Quinteto-de-nos/lumbapp/README.md

# lumbapp
Repo principal del simulador de puncion lumbar
