Quinteto-de-nos/lumbapp/LumbApp/README.txt

Podés enviar tus consultas a: info.lumbapp@gmail.com

Nuestro repo de Github es: https://github.com/Quinteto-de-nos/lumbapp
