Quinteto-de-nos/lumbapp/LumbApp/docs/Manual de instalación.pdf

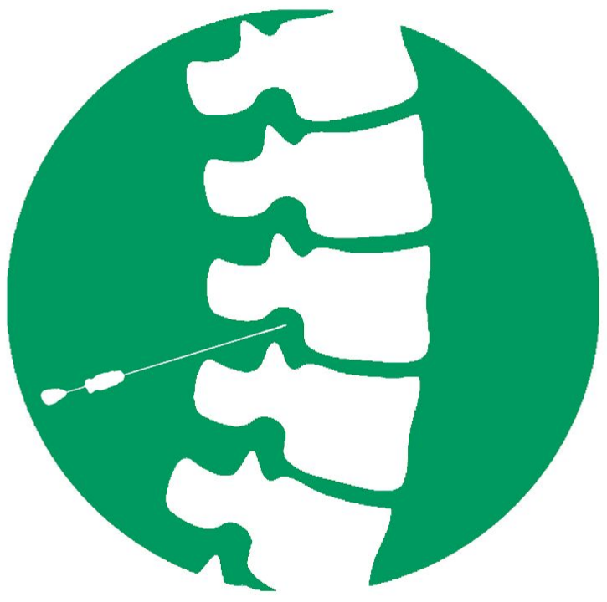
[picture p15: figure]

# Manual de Instalación

Gracias por elegir LumbApp, el simulador de punciones lumbares.
LumbApp es más que un simple simulador: es un guía virtual que acompañará al practicante durante cada práctica.
Para poder utilizar LumbApp, deberá instalar la aplicación de escritorio.

## Archivos de instalación

La aplicación LumbApp incluye un archivo de instalación llamado “LumbApp Desktop.msi”, que incluye todo lo necesario para instalar la aplicación de escritorio LumbApp.

## Pasos de instalación

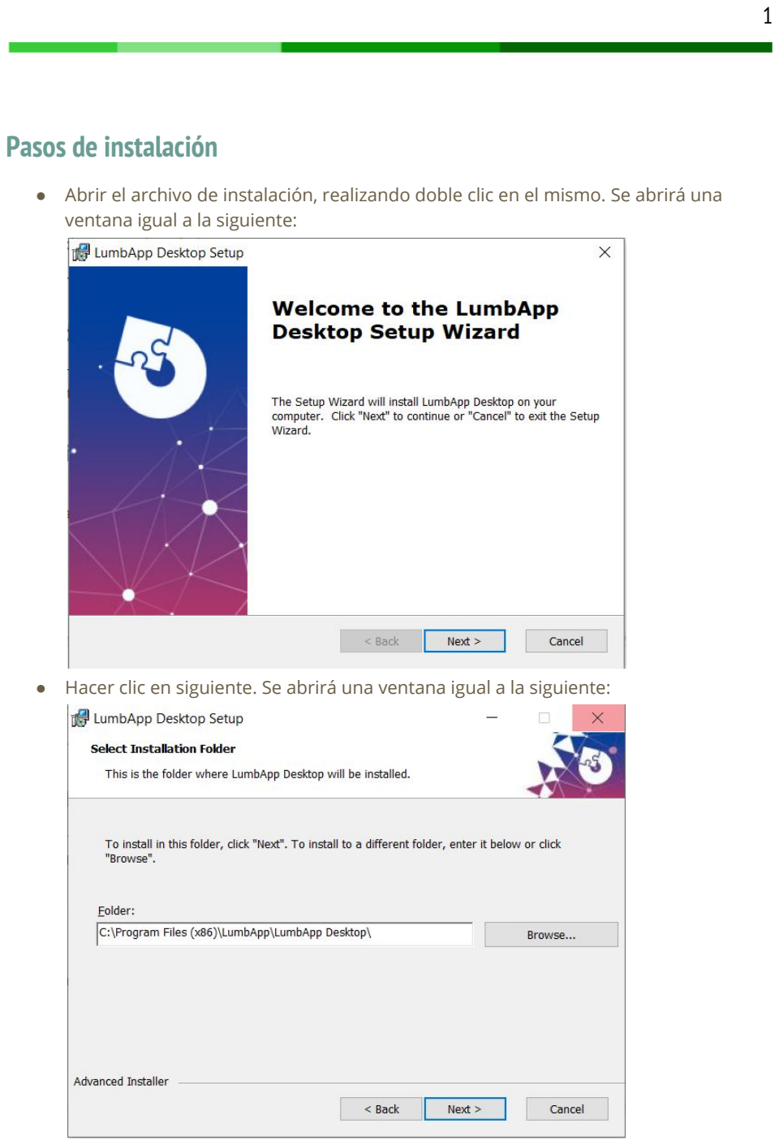
[picture p16: page 2]

- Abrir el archivo de instalación, realizando doble clic en el mismo. Se abrirá una ventana igual a la siguiente:
- Hacer clic en siguiente. Se abrirá una ventana igual a la siguiente:

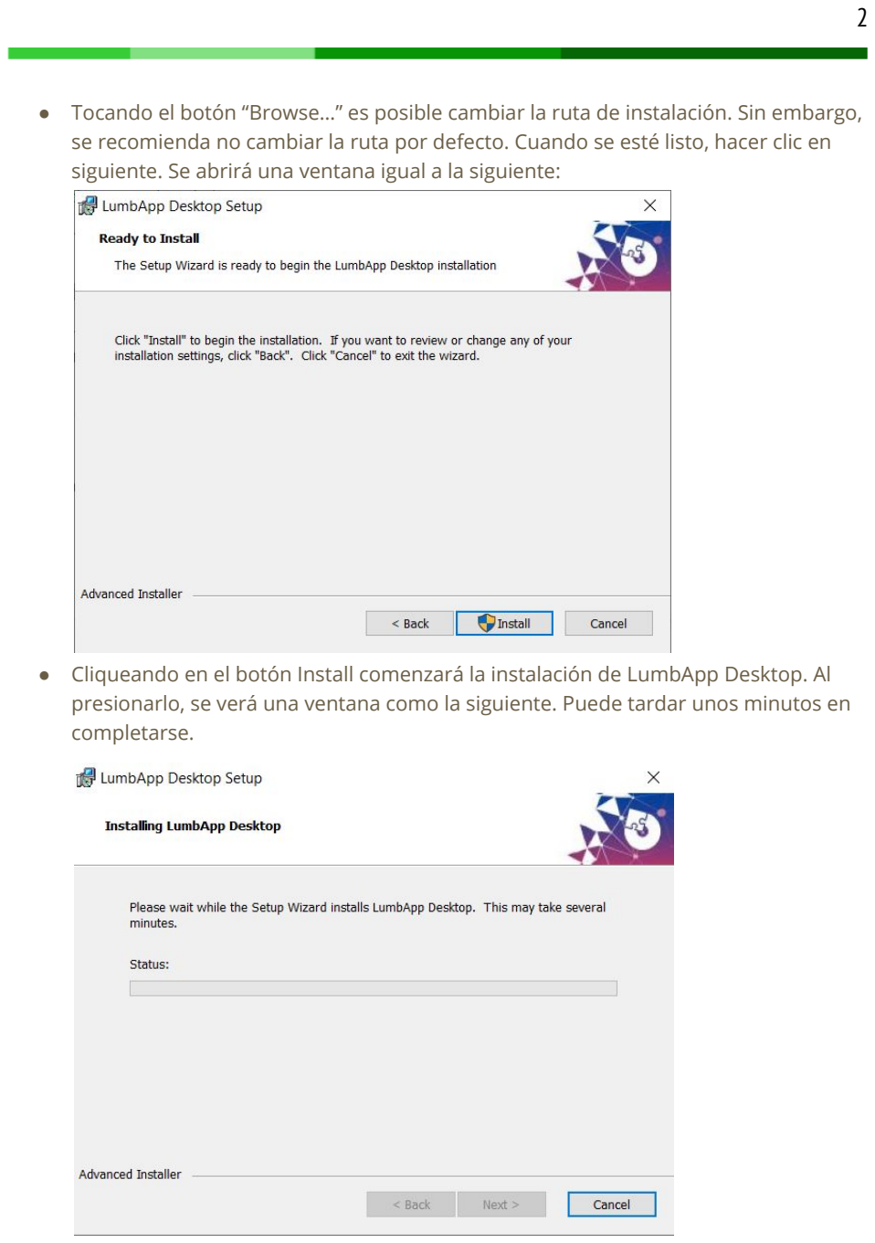
[picture p17: page 3]

- Tocando el botón “Browse…” es posible cambiar la ruta de instalación. Sin embargo, se recomienda no cambiar la ruta por defecto. Cuando se esté listo, hacer clic en siguiente. Se abrirá una ventana igual a la siguiente:
- Cliqueando en el botón Install comenzará la instalación de LumbApp Desktop. Al presionarlo, se verá una ventana como la siguiente. Puede tardar unos minutos en completarse.

- Cuando la instalación termine, se verá la siguiente ventana:

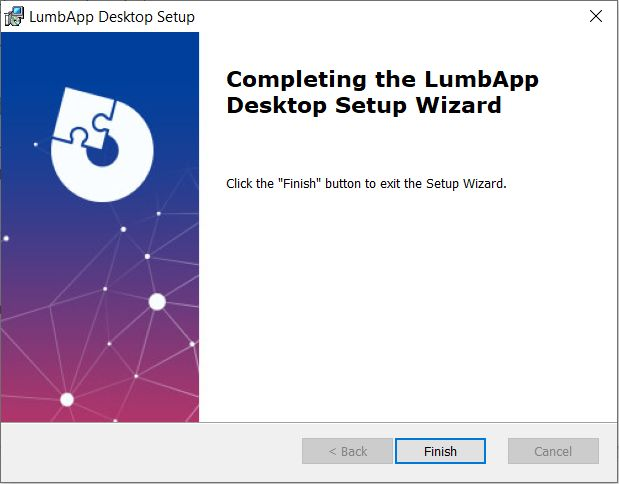
[picture p18: figure]

- Hacer clic en Finish. La instalación estará completada, y habrá un acceso directo a la aplicación en el escritorio:

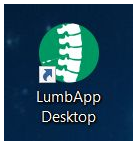
[picture p19: figure]

## Instalación de Drivers

Para el funcionamiento de LumbApp es necesario instalar los drivers de Kinect y Arduino UNO.

## Instalación de drivers de Arduino

En primer lugar tenemos que descargar los drivers en nuestra PC. Para ello, debemos descargarlos en este enlace (https://www.arduino.cc/en/Main/Software) . Seleccionar la opción “Windows ZIP file”. Se trata de un archivo zip, que se va a descargar de forma automática.

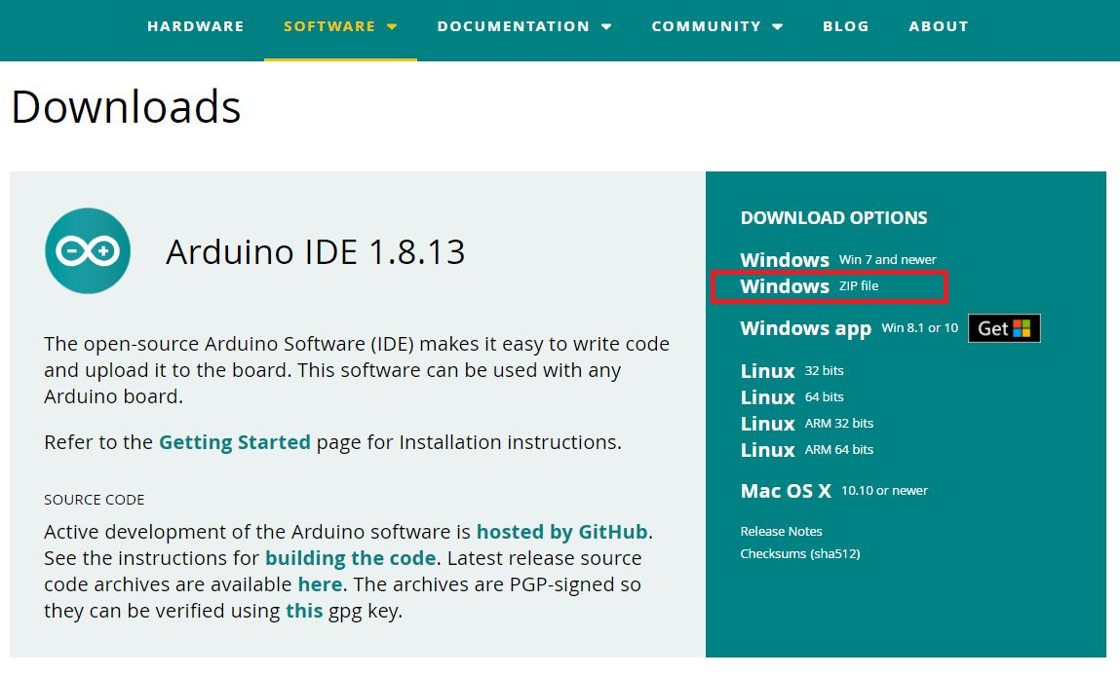
[picture p20: figure]

Una vez descargado el archivo zip, descomprimirlo. Luego, abrir la carpeta “drivers” y, si tu sistema operativo Windows 10 es de 64 bits, ejecutar el archivo “dpinst-amd64.exe”, o bien, si es de 32 bits, ejecutar el archivo "dpinst-x86.exe". Una vez ejecutado, hacer clic en el botón “Siguiente”, para continuar.

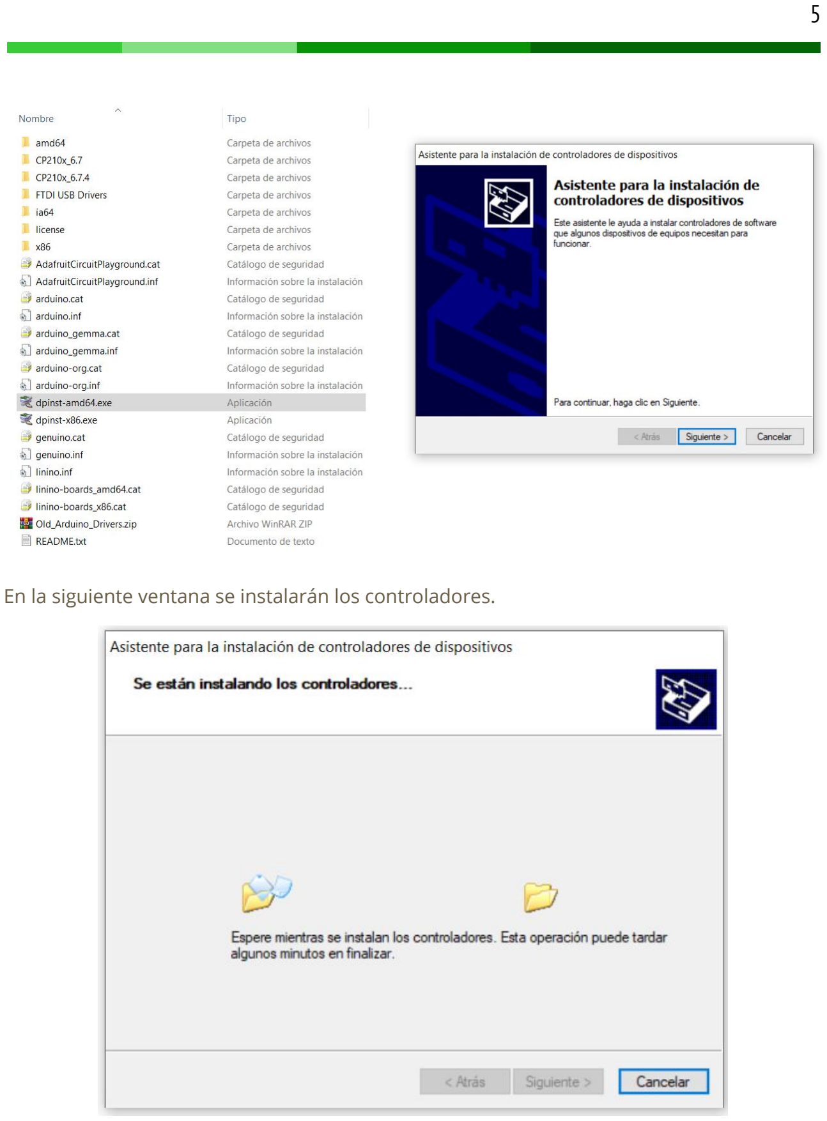
[picture p21: page 6]

En la siguiente ventana se instalarán los controladores.

Cuando la instalación de los drivers finalice, se verá la siguiente pantalla

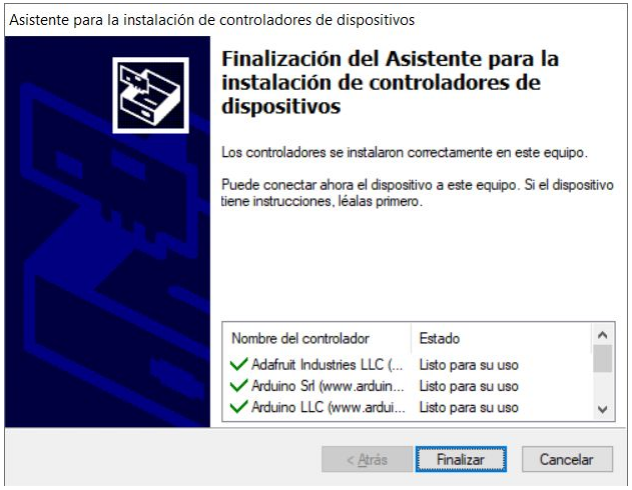
[picture p22: figure]

## Instalación de los drivers de Kinect

En primer lugar tenemos que descargar los drivers en nuestra PC. Para ello, debemos descargarlos en este enlace. (https://www.microsoft.com/en-us/download/details.aspx?id=40278) Descargamos el SDK 1.8 (las versiones más nuevas no son compatibles con la Kinect XBOX 360 que utiliza LumbApp). Para esto, solo hay que seleccionar la opción “Download”. Se trata de un archivo “KinectSDK-v1.8-Setup.exe”, que se va a descargar de forma automática.

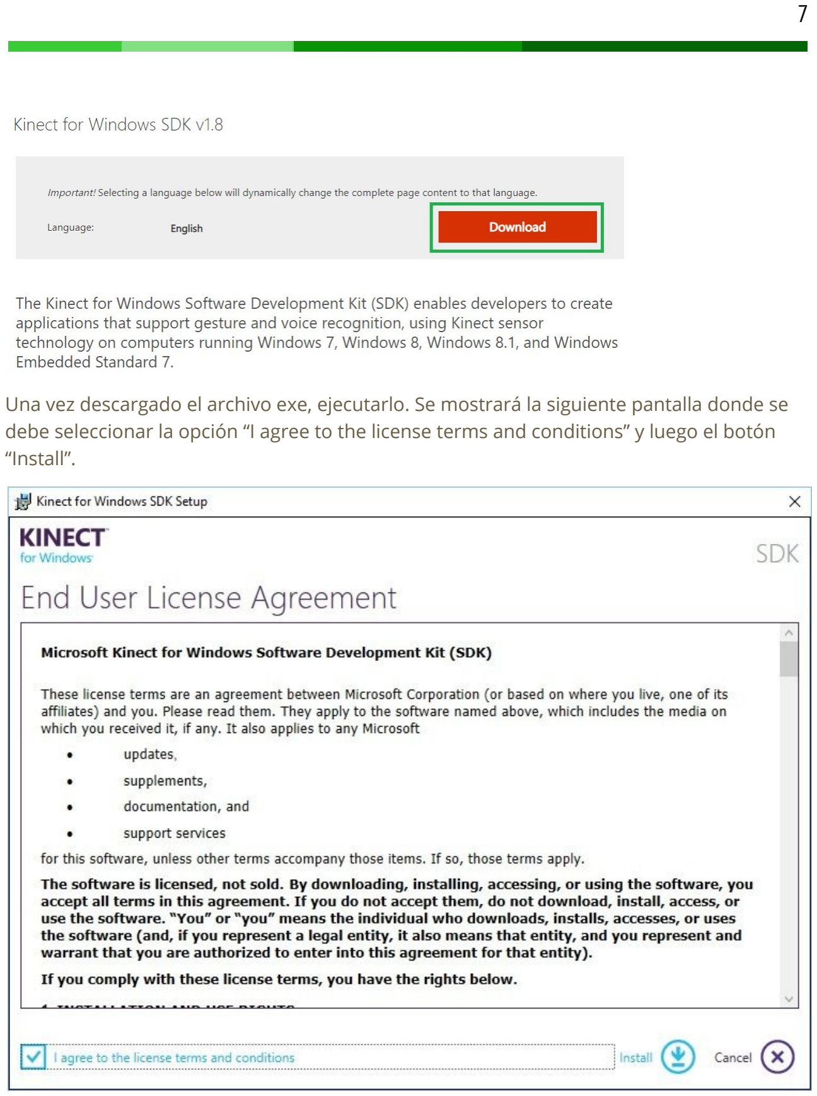
[picture p23: page 8]

Una vez descargado el archivo exe, ejecutarlo. Se mostrará la siguiente pantalla donde se debe seleccionar la opción “I agree to the license terms and conditions” y luego el botón “Install”.

Cuando la instalación de los drivers finalice, se mostrará la siguiente pantalla. No es necesario descargar el Developer Toolkit que menciona el instalador. Hacer clic en el botón “Close” para terminar.

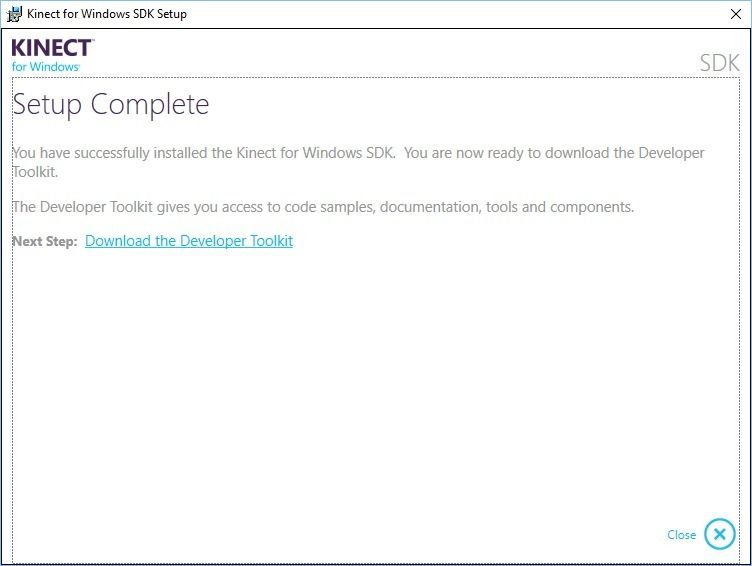
[picture p24: figure]

## Desinstalación

En caso de querer desinstalar la aplicación, se deben seguir los siguientes pasos (Windows 10):
- Abrir “Aplicaciones y características” en la barra de búsqueda.
- En el buscador, escribir “Lumbapp”.

- Entre las aplicaciones seleccionar LumbApp, y tocar el botón “Desinstalar”:

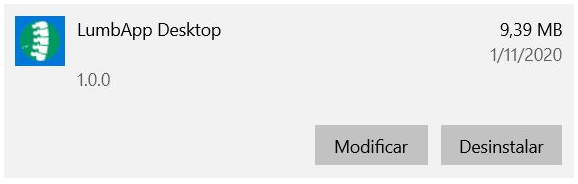
[picture p25: figure]

- Seguir los pasos del asistente de desinstalación de Windows para eliminar la aplicación del sistema.
