Quinteto-de-nos/lumbapp/LumbApp Arduino/mapeo_puertos.ino

#define L2 2
#define L3Arriba 3
#define L3Abajo 4
#define L4ArribaIzquierda 5
#define L4ArribaCentro 6
#define L4ArribaDerecha 7
#define L4Abajo 8
#define Duramadre 9
#define L5 10
#define TejidoAdiposo 11

#define echoPin 13
char estado_puertos [11] = {"0000000000$"}; //inicializo el vector de estados
char recibido = 0;
bool iniciamos = true;

void setup() {
  pinMode(2, INPUT_PULLUP);    // L2
  pinMode(3, INPUT_PULLUP);    // L3 arriba
  pinMode(4, INPUT_PULLUP);    // L3 abajo
  pinMode(5, INPUT_PULLUP);    // L4 arriba izq
  pinMode(6, INPUT_PULLUP);    // L4 arriba arriba centro
  pinMode(7, INPUT_PULLUP);    // L4 arriba derecha
  pinMode(8, INPUT_PULLUP);    // L4 abajo
  pinMode(9, INPUT_PULLUP);    // duramadre
  pinMode(10, INPUT_PULLUP);    // L5
  pinMode(11, INPUT_PULLUP);    // Tejido Adipooso

  Serial.begin(9600);
}

void loop() {
  if (iniciamos == true){
      estado_puertos[0] = (char) (digitalRead(TejidoAdiposo) + 48);
      estado_puertos[1] = (char) (digitalRead(L2) + 48);
      estado_puertos[2] = (char) (digitalRead(L3Arriba) + 48);
      estado_puertos[3] = (char) (digitalRead(L3Abajo) + 48);
      estado_puertos[4] = (char) (digitalRead(L4ArribaIzquierda) + 48);
      estado_puertos[5] = (char) (digitalRead(L4ArribaDerecha) + 48);
      estado_puertos[6] = (char) (digitalRead(L4ArribaCentro) + 48);
      estado_puertos[7] = (char) (digitalRead(L4Abajo) + 48);
      estado_puertos[8] = (char) (digitalRead(L5) + 48);
      estado_puertos[9] = (char) (digitalRead(Duramadre) + 48);
  
      Serial.println(estado_puertos);
  
      delay(500);
  }
  else {       //Si el Arduino no está iniciado, espera una 'p' para iniciarse
      recibido = (char)Serial.read();
                  
      if(recibido  == 'p'){       //Si recibo 'p', envío '0000' como respuesta e iniciamos
           Serial.println("0000$");
           iniciamos = true;
                        
      } else {     // Si no recibo 'p', envío '9999' (un string que no contenga 0s ó 1s)
          //Serial.println("waiting$");
          Serial.println ("9999$");
      }      
  }
}
