Quinteto-de-nos/lumbapp/(commit log)

2020-07-10 arduino read conector
2020-07-10 Proyecto de visual studio
2020-07-10 Termino de armar el test
2020-07-11 limpio un poco el test
2020-07-11 Constructor, init y finalizar para expert
2020-07-11 framesReady en expert
2020-07-20 Tests y cosas por la mitad
2020-07-20 Test dentro o fuera de ZE
2020-07-20 Mano con cambios de estado
2020-07-26 Se agraga estructura del orquestador y de refactorea todo lo realcionado a los sensores internos con la estructura acordada
2020-07-28 retry button
2020-07-29 Estructura de comunicación entre Orquestador y ExpertoSI
2020-07-29 pantalla checkeo de sensores v1
2020-07-30 sensors check screen
2020-08-01 Actualizaciones de la estructura
2020-08-01 Prueba de evento
2020-08-01 Info de tracking
2020-08-01 Docs de pruebas
2020-08-02 correccion de namespace
2020-08-02 se validan datos ingresados por el usuario
2020-08-05 validacion de mail y cambio de estilo en login
2020-08-05 inicio pasos de preparacion
2020-08-09 Primeros intentos de reconocer puntos en pantalla
2020-08-09 se agregan imagenes de estados de manos
2020-08-09 Actualización de inicializar
2020-08-09 se agrega esqueleto de mostrarCambioZE
2020-08-11 corrijo problema de merge
2020-08-13 borro cosas viejas y avanzo con logica de mostrar cambios en ZE
2020-08-30 Para que buildee
2020-08-30 Que arranque la prueba de kinect
2020-09-02 refactor de experto SI
2020-09-03 Más cambios en la arquitectura del experto
2020-09-04 Arreglo error en el conectorSI original
2020-09-04 simulacion de manos en zona completa y ciclo de simulacion modo guiado
2020-09-05 cosas por la mitad
2020-09-05 mas cosas por la mitad
2020-09-05 corregi la logica de mostrar las manos, ya no vuelve a checkear por los estados
2020-09-06 Agrego tests y correcciones para el buen funcionamiento de Comenzar y Terminar simulación.
2020-09-06 Agrego lo necesario para obtener estadísticas del sensado interno
2020-09-06 Para que compile
2020-09-06 Agregamos cambios en inicializar SI checkeando la comunicación con el arduino.
2020-09-09 added test for the calibration class
2020-09-09 Validaciones de datos personales
2020-09-09 Saco cosas de mas
2020-09-12 Últimos tests para vertebras
2020-09-12 Areglo error de mergeo + algunas cosas públicas demás
2020-09-14 timer added to PasosPreparacion Page
2020-09-17 avances en pasos de preparacion
2020-09-18 cambios en pasos de preparacion
2020-09-21 Agrego gets para los tests y un tests más para probar que esté arreglado el bug del informe
2020-09-21 correccion de dimensiones de pantalla
2020-09-24 Agrego todos los cambios necesarios para la selección de modo en el orquestador
2020-09-27 Subo las imagenes de capas y vertebras
2020-09-27 Arreglando errores de build y tests
2020-09-28 mockeo arduino
2020-09-28 agrego mockeo de SI
2020-09-29 update de packages
2020-09-29 borro packages de mas
2020-09-30 las cosas que uno tiene que hacer...
2020-09-30 agrego mensajes de alerta v1 y usando ambos mocks en orquestador
2020-09-30 Generación de pdf v1
2020-10-01 Actualización con formato de tupla
2020-10-02 Cambio de Tupla a OrderedDictionary
2020-10-02 pruebas de ordered dictionary
2020-10-02 cambios de estilo en login y se agrega watermark
2020-10-03 pruebo guardar en el momento
2020-10-04 Logs sensores internos
2020-10-04 cambios de estilos de los botones
2020-10-05 correcciones de merge
2020-10-06 Tildes para nombres y apellidos
2020-10-08 intento de mejorar el tracking
2020-10-10 10cm de margen
2020-10-10 Saco linea de prueba
2020-10-10 Borro cosas de mas
2020-10-15 muevo cosas de lugar
2020-10-15 Dejo pasar la excepcion
2020-10-16 wording y cambio de distribucion en pantalla de simulacion modo guiado
2020-10-17 Arreglo error de mocks
2020-10-17 formato de info del alumno v2
2020-10-17 added calibrator and deleted json by default
2020-10-17 Se arregló evento de sensores internos en la gui y otras cosillas
2020-10-18 saco archivos de prueba de arduino
2020-10-18 saco Shallowcopy de CambioSIEventArgs
2020-10-18 correccion de espacios en multiline text PasosPreparacion
2020-10-19 probando lineas en tabla de datos del alumno
2020-10-19 compila de vuelta
2020-10-20 corrijo thread para gui
2020-10-20 Se agrega apagado de arduino
2020-10-22 cambio en imagenes de manos
2020-10-22 Quito código comentado y agrego primer lína de tabla Estadísticas
2020-10-22 Ahora sí, fix de tiempo total
2020-10-23 cambio de estilo en pantalla SensorsCheck
2020-10-24 Agrego variables _simulando para controlar los eventos de cambio
2020-10-25 saco todo lo que llama a los caminos correctos
2020-10-30 cambio colores de etiquetas de manos para matchear a imagenes
2020-10-31 Revert "cambio colores de etiquetas de manos para matchear a imagenes"
    This reverts commit 54eaf8418150ec650c36d37f37bab3b9a9a30134.
2020-10-31 recorto imagenes de frente
2020-10-31 cambio colores labels manos para matchear imagenes
2020-10-31 corrijo label rozando cambiaba fondo cuando se atravesaba la duramadre
2020-10-31 saco cartel de espera en resultados y agrego spinner de "guardando resultados"
2020-11-02 icono para calibracion
2020-11-18 cambio de urls en imagenes del front
2020-11-19 imagenes de gui se extraen solas
2020-11-19 logo para el pdf se exporta solo
2020-11-19 algo que estaba de mas
2020-11-19 content en vez de resources
2020-11-19 Revert "content en vez de resources"
    This reverts commit ea408517294d0056e83a8b28f2303e2c59ceac99.
2020-11-19 Revert "algo que estaba de mas"
    This reverts commit f2f7d7a8de1df96224e2a09a05a46fdc4d06e108.
2021-03-05 Agrego código para el mapeo de puertos
